pauloapanucci/tcc/README.md

# tcc
Repositório de códigos, imagens e fontes de LaTex do TCC desenvolvido por Paulo Alexandre Piornedo Panucci RA 88380 

Departamento de Informática

Universidade Estadual de Maringá
