pauloapanucci/tcc/imgs/screen2.gif

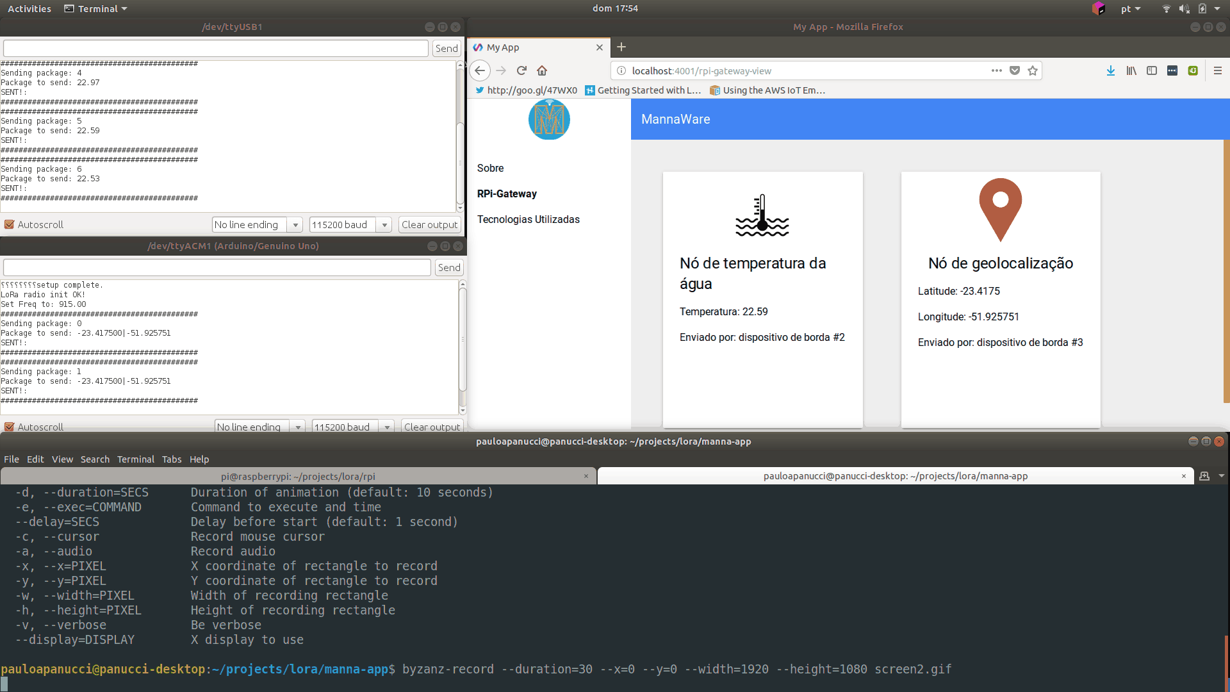
imgs/screen2.gif
