pauloapanucci/tcc/latex-repo/bigpicprototipo.png

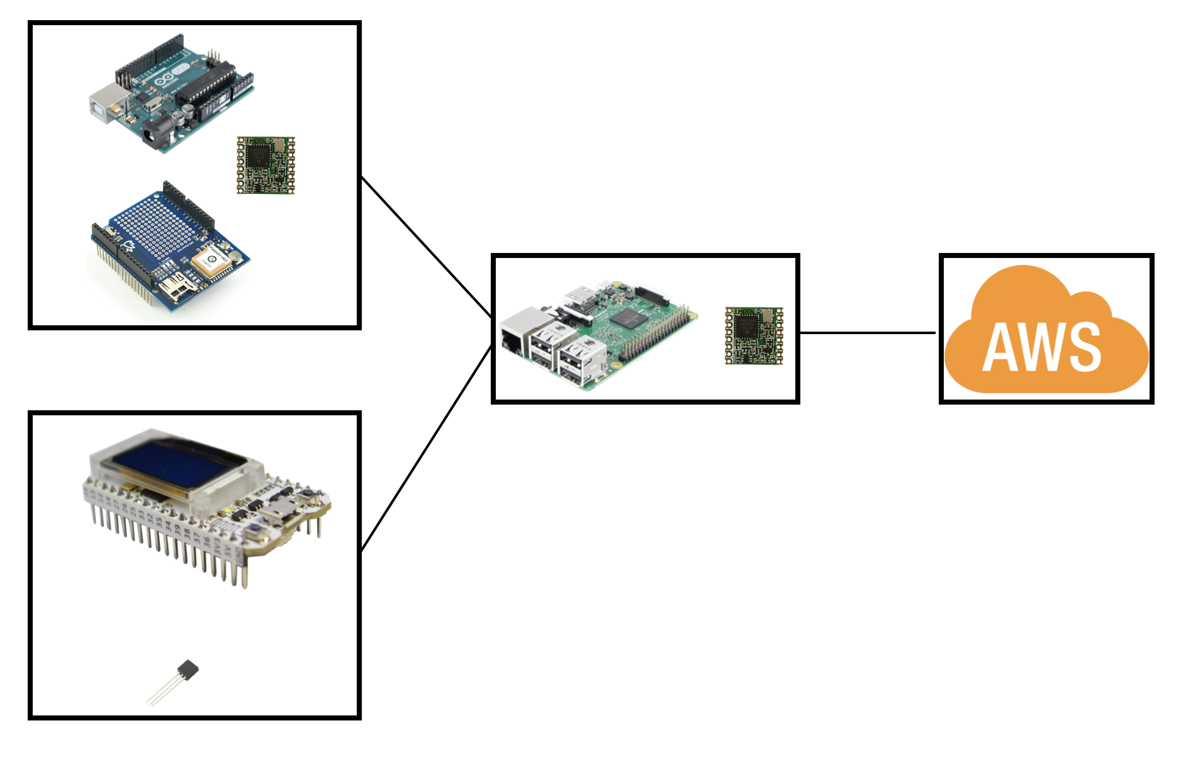
latex-repo/bigpicprototipo.png
