pauloapanucci/tcc/src/mannaware/images/manna.png

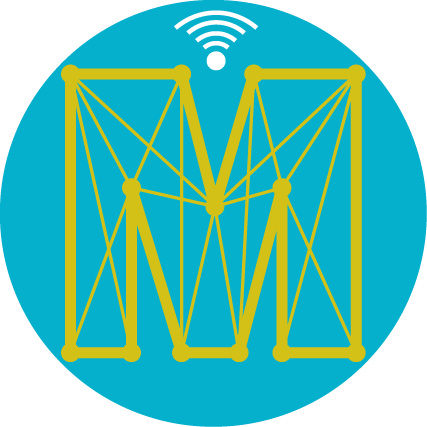
src/mannaware/images/manna.png
