pauloapanucci/tcc/src/mannaware/images/watertemp.png

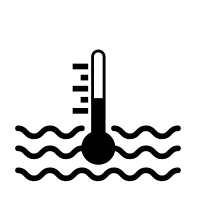
src/mannaware/images/watertemp.png
