pauloapanucci/tcc/src/mannaware/scripts/desktop2.gif

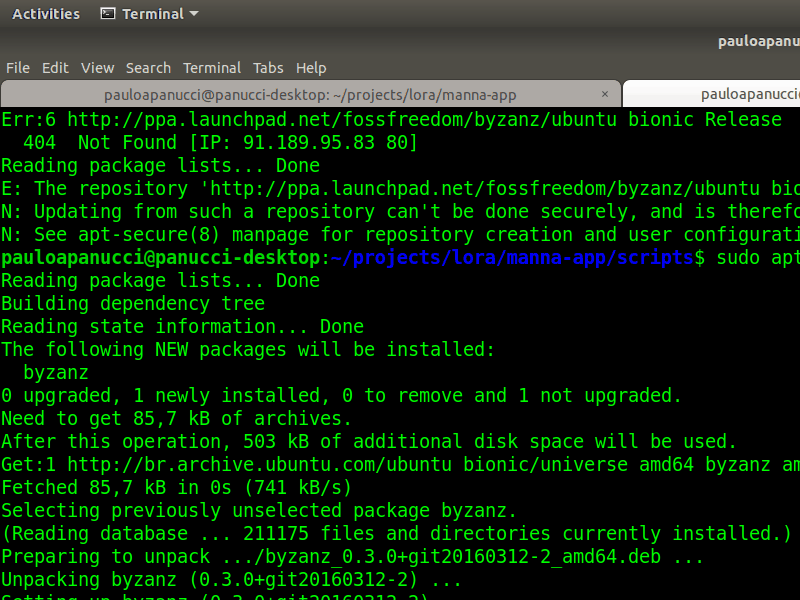
src/mannaware/scripts/desktop2.gif
