pauloapanucci/tcc/src/mannaware/scripts/desktop.gif

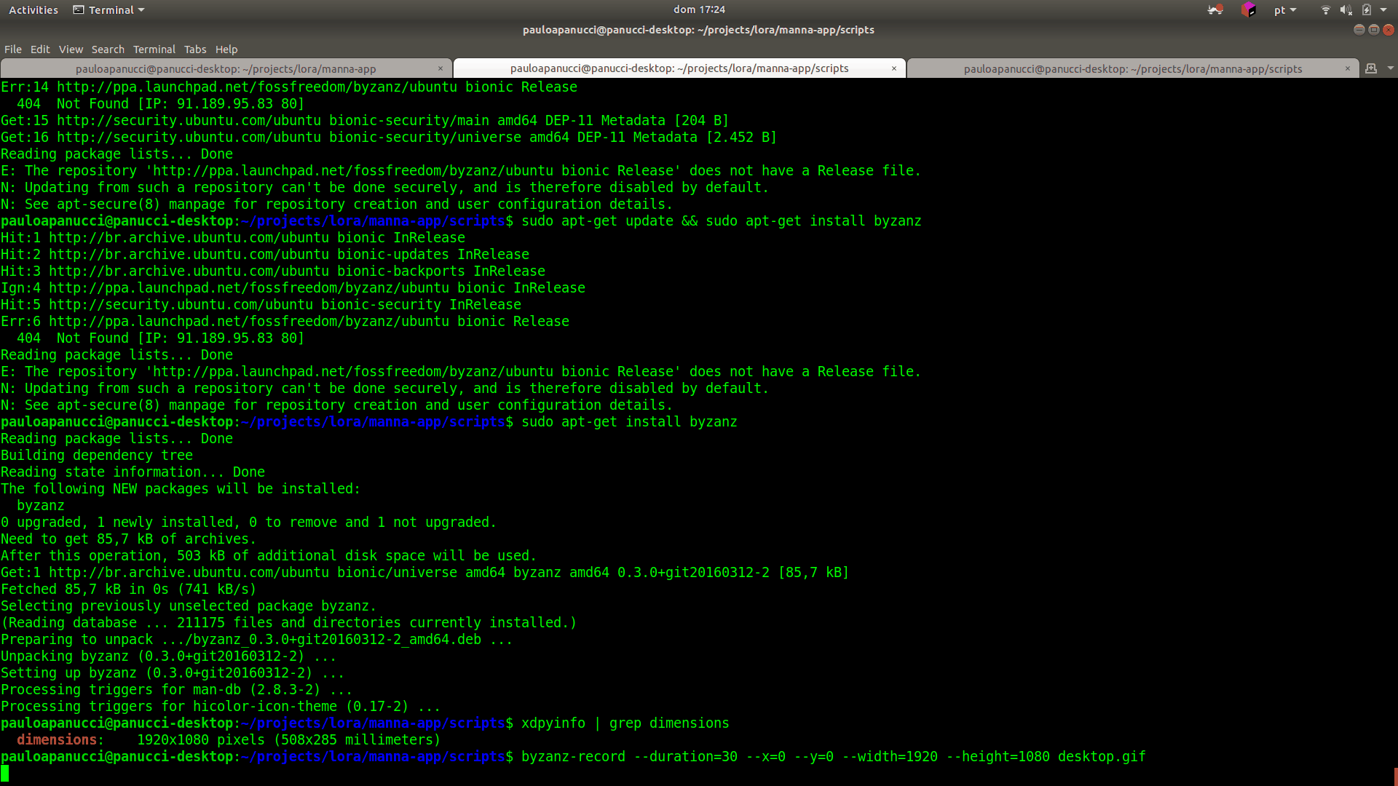
src/mannaware/scripts/desktop.gif
