pauloapanucci/tcc/src/setup/Heltec_WIFI-LoRa-32_DiagramPinout.jpg

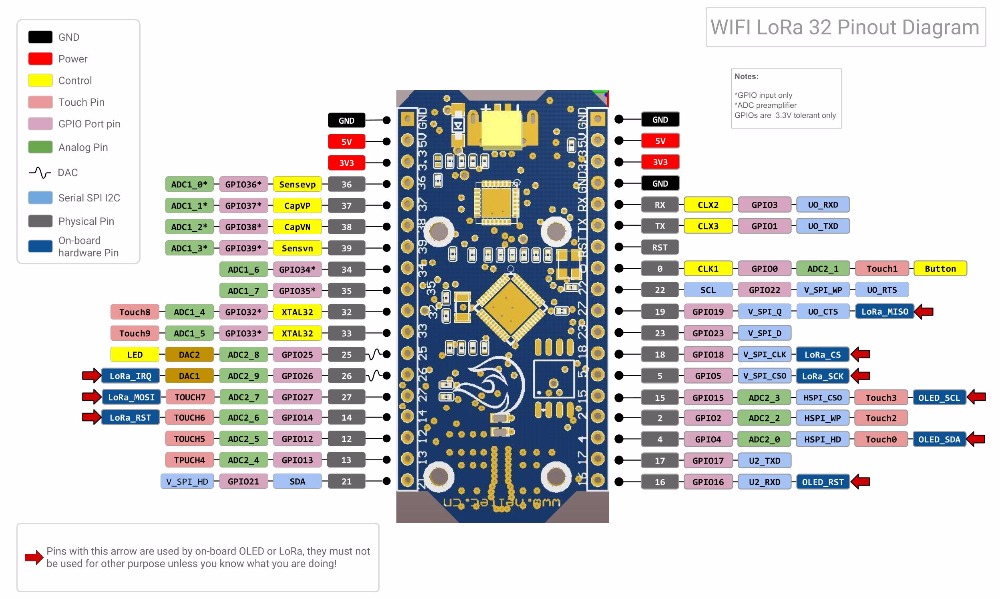
src/setup/Heltec_WIFI-LoRa-32_DiagramPinout.jpg
