pauloapanucci/tcc/src/setup/arduinomicro-rfm95pw.jpeg

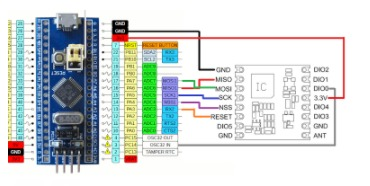
src/setup/arduinomicro-rfm95pw.jpeg
