pauloapanucci/tcc/src/setup/arduinouno-rfm95w.jpeg

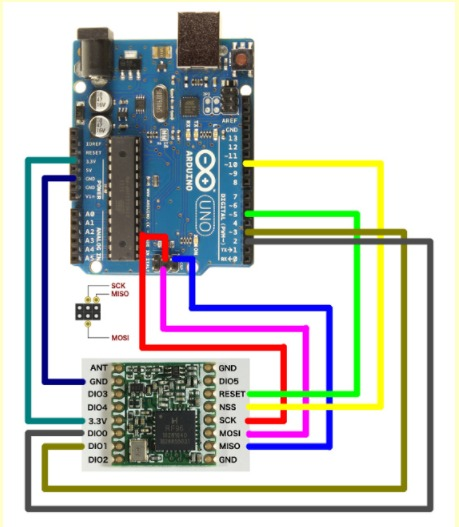
src/setup/arduinouno-rfm95w.jpeg
