pauloapanucci/tcc/src/setup/HopeRF_RFM95PW-schema.png

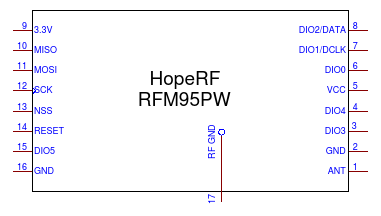
src/setup/HopeRF_RFM95PW-schema.png
