pauloapanucci/tcc/src/setup/RFM95W- Layout.jpg

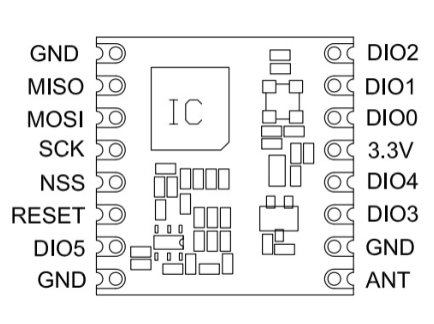
src/setup/RFM95W- Layout.jpg
