pauloapanucci/tcc/(list of files, drawings)

Other design files:
imgs/rpi-rf.fzz
imgs/uno-rf.fzz
