pauloapanucci/tcc/src/gateway/gateway.cpp

#include <bcm2835.h>
#include <stdio.h>
#include <signal.h>
#include <unistd.h>
#include <stdlib.h>
#include <ctype.h>
#include <string.h>
#include <limits.h>

#include "aws_iot_config.h"
#include "aws_iot_log.h"
#include "aws_iot_version.h"
#include "aws_iot_mqtt_client_interface.h"
#include "aws_iot_shadow_interface.h"

#include <RH_RF69.h>
#include <RH_RF95.h>

// define hardware used change to fit your need
// Uncomment the board you have, if not listed 
// uncommment custom board and set wiring tin custom section

// LoRasPi board 
// see https://github.com/hallard/LoRasPI
#define BOARD_LORASPI

// iC880A and LinkLab Lora Gateway Shield (if RF module plugged into)
// see https://github.com/ch2i/iC880A-Raspberry-PI
//#define BOARD_IC880A_PLATE

// Raspberri PI Lora Gateway for multiple modules 
// see https://github.com/hallard/RPI-Lora-Gateway
//#define BOARD_PI_LORA_GATEWAY

// Dragino Raspberry PI hat
// see https://github.com/dragino/Lora
//#define BOARD_DRAGINO_PIHAT

// Now we include RasPi_Boards.h so this will expose defined 
// constants with CS/IRQ/RESET/on board LED pins definition
#include "./RadioHead/examples/raspi/RasPiBoards.h"

// Our RFM95 Configuration 
#define RF_FREQUENCY  915.00
#define RF_NODE_ID    1

// Create an instance of a driver
RH_RF95 rf95(RF_CS_PIN, RF_IRQ_PIN);
//RH_RF95 rf95(RF_CS_PIN);

//Flag for Ctrl-C
volatile sig_atomic_t force_exit = false;

//AWS EXAMPLE
#define ROOMTEMPERATURE_UPPERLIMIT 32.0f
#define ROOMTEMPERATURE_LOWERLIMIT 25.0f
#define STARTING_ROOMTEMPERATURE ROOMTEMPERATURE_LOWERLIMIT

#define MAX_LENGTH_OF_UPDATE_JSON_BUFFER 200

static char certDirectory[PATH_MAX + 1] = "../../../certs";
#define HOST_ADDRESS_SIZE 255
static char HostAddress[HOST_ADDRESS_SIZE] = AWS_IOT_MQTT_HOST;
static uint32_t port = AWS_IOT_MQTT_PORT;
static uint8_t numPubs = 5;

static void simulateRoomTemperature(float *pRoomTemperature) {
	static float deltaChange;

	if(*pRoomTemperature >= ROOMTEMPERATURE_UPPERLIMIT) {
		deltaChange = -0.5f;
	} else if(*pRoomTemperature <= ROOMTEMPERATURE_LOWERLIMIT) {
		deltaChange = 0.5f;
	}

	*pRoomTemperature += deltaChange;
}

void ShadowUpdateStatusCallback(const char *pThingName, ShadowActions_t action, Shadow_Ack_Status_t status,
								const char *pReceivedJsonDocument, void *pContextData) {
	IOT_UNUSED(pThingName);
	IOT_UNUSED(action);
	IOT_UNUSED(pReceivedJsonDocument);
	IOT_UNUSED(pContextData);

	if(SHADOW_ACK_TIMEOUT == status) {
		IOT_INFO("Update Timeout--");
	} else if(SHADOW_ACK_REJECTED == status) {
		IOT_INFO("Update RejectedXX");
	} else if(SHADOW_ACK_ACCEPTED == status) {
		IOT_INFO("Update Accepted !!");
	}
}

void windowActuate_Callback(const char *pJsonString, uint32_t JsonStringDataLen, jsonStruct_t *pContext) {
	IOT_UNUSED(pJsonString);
	IOT_UNUSED(JsonStringDataLen);

	if(pContext != NULL) {
		IOT_INFO("Delta - Window state changed to %d", *(bool *) (pContext->pData));
	}
}

void parseInputArgsForConnectParams(int argc, char **argv) {
	int opt;

	while(-1 != (opt = getopt(argc, argv, "h:p:c:n:"))) {
		switch(opt) {
			case 'h':
				strncpy(HostAddress, optarg, HOST_ADDRESS_SIZE);
				IOT_DEBUG("Host %s", optarg);
				break;
			case 'p':
				port = atoi(optarg);
				IOT_DEBUG("arg %s", optarg);
				break;
			case 'c':
				strncpy(certDirectory, optarg, PATH_MAX + 1);
				IOT_DEBUG("cert root directory %s", optarg);
				break;
			case 'n':
				numPubs = atoi(optarg);
				IOT_DEBUG("num pubs %s", optarg);
				break;
			case '?':
				if(optopt == 'c') {
					IOT_ERROR("Option -%c requires an argument.", optopt);
				} else if(isprint(optopt)) {
					IOT_WARN("Unknown option `-%c'.", optopt);
				} else {
					IOT_WARN("Unknown option character `\\x%x'.", optopt);
				}
				break;
			default:
				IOT_ERROR("ERROR in command line argument parsing");
				break;
		}
	}

}

//END AWS EXAMPLE

// int main(int argc, char **argv) {
	// IoT_Error_t rc = FAILURE;
	// int32_t i = 0;

	// char JsonDocumentBuffer[MAX_LENGTH_OF_UPDATE_JSON_BUFFER];
	// size_t sizeOfJsonDocumentBuffer = sizeof(JsonDocumentBuffer) / sizeof(JsonDocumentBuffer[0]);
	// char *pJsonStringToUpdate;
	// float temperature = 0.0;

	// bool windowOpen = false;
	// jsonStruct_t windowActuator;
	// windowActuator.cb = windowActuate_Callback;
	// windowActuator.pData = &windowOpen;
	// windowActuator.dataLength = sizeof(bool);
	// windowActuator.pKey = "windowOpen";
	// windowActuator.type = SHADOW_JSON_BOOL;

	// jsonStruct_t temperatureHandler;
	// temperatureHandler.cb = NULL;
	// temperatureHandler.pKey = "temperature";
	// temperatureHandler.pData = &temperature;
	// temperatureHandler.dataLength = sizeof(float);
	// temperatureHandler.type = SHADOW_JSON_FLOAT;

	// char rootCA[PATH_MAX + 1];
	// char clientCRT[PATH_MAX + 1];
	// char clientKey[PATH_MAX + 1];
	// char CurrentWD[PATH_MAX + 1];

	// IOT_INFO("\nAWS IoT SDK Version %d.%d.%d-%s\n", VERSION_MAJOR, VERSION_MINOR, VERSION_PATCH, VERSION_TAG);

	// getcwd(CurrentWD, sizeof(CurrentWD));
	// snprintf(rootCA, PATH_MAX + 1, "%s/%s/%s", CurrentWD, certDirectory, AWS_IOT_ROOT_CA_FILENAME);
	// snprintf(clientCRT, PATH_MAX + 1, "%s/%s/%s", CurrentWD, certDirectory, AWS_IOT_CERTIFICATE_FILENAME);
	// snprintf(clientKey, PATH_MAX + 1, "%s/%s/%s", CurrentWD, certDirectory, AWS_IOT_PRIVATE_KEY_FILENAME);

	// IOT_DEBUG("rootCA %s", rootCA);
	// IOT_DEBUG("clientCRT %s", clientCRT);
	// IOT_DEBUG("clientKey %s", clientKey);

	// parseInputArgsForConnectParams(argc, argv);

	// // initialize the mqtt client
	// AWS_IoT_Client mqttClient;

	// ShadowInitParameters_t sp = ShadowInitParametersDefault;
	// sp.pHost = AWS_IOT_MQTT_HOST;
	// sp.port = AWS_IOT_MQTT_PORT;
	// sp.pClientCRT = clientCRT;
	// sp.pClientKey = clientKey;
	// sp.pRootCA = rootCA;
	// sp.enableAutoReconnect = false;
	// sp.disconnectHandler = NULL;

	// IOT_INFO("Shadow Init");
	// rc = aws_iot_shadow_init(&mqttClient, &sp);
	// if(SUCCESS != rc) {
	// 	IOT_ERROR("Shadow Connection Error");
	// 	return rc;
	// }

	// ShadowConnectParameters_t scp = ShadowConnectParametersDefault;
	// scp.pMyThingName = AWS_IOT_MY_THING_NAME;
	// scp.pMqttClientId = AWS_IOT_MQTT_CLIENT_ID;
	// scp.mqttClientIdLen = (uint16_t) strlen(AWS_IOT_MQTT_CLIENT_ID);

	// IOT_INFO("Shadow Connect");
	// rc = aws_iot_shadow_connect(&mqttClient, &scp);
	// if(SUCCESS != rc) {
	// 	IOT_ERROR("Shadow Connection Error");
	// 	return rc;
	// }

	// /*
	//  * Enable Auto Reconnect functionality. Minimum and Maximum time of Exponential backoff are set in aws_iot_config.h
	//  *  #AWS_IOT_MQTT_MIN_RECONNECT_WAIT_INTERVAL
	//  *  #AWS_IOT_MQTT_MAX_RECONNECT_WAIT_INTERVAL
	//  */
	// rc = aws_iot_shadow_set_autoreconnect_status(&mqttClient, true);
	// if(SUCCESS != rc) {
	// 	IOT_ERROR("Unable to set Auto Reconnect to true - %d", rc);
	// 	return rc;
	// }

	// rc = aws_iot_shadow_register_delta(&mqttClient, &windowActuator);

	// if(SUCCESS != rc) {
	// 	IOT_ERROR("Shadow Register Delta Error");
	// }
	// temperature = STARTING_ROOMTEMPERATURE;

	// // loop and publish a change in temperature
	// while(NETWORK_ATTEMPTING_RECONNECT == rc || NETWORK_RECONNECTED == rc || SUCCESS == rc) {
	// 	rc = aws_iot_shadow_yield(&mqttClient, 200);
	// 	if(NETWORK_ATTEMPTING_RECONNECT == rc) {
	// 		sleep(1);
	// 		// If the client is attempting to reconnect we will skip the rest of the loop.
	// 		continue;
	// 	}
	// 	IOT_INFO("\n=======================================================================================\n");
	// 	IOT_INFO("On Device: window state %s", windowOpen ? "true" : "false");
	// 	simulateRoomTemperature(&temperature);

	// 	rc = aws_iot_shadow_init_json_document(JsonDocumentBuffer, sizeOfJsonDocumentBuffer);
	// 	if(SUCCESS == rc) {
	// 		rc = aws_iot_shadow_add_reported(JsonDocumentBuffer, sizeOfJsonDocumentBuffer, 2, &temperatureHandler,
	// 										 &windowActuator);
	// 		if(SUCCESS == rc) {
	// 			rc = aws_iot_finalize_json_document(JsonDocumentBuffer, sizeOfJsonDocumentBuffer);
	// 			if(SUCCESS == rc) {
	// 				IOT_INFO("Update Shadow: %s", JsonDocumentBuffer);
	// 				rc = aws_iot_shadow_update(&mqttClient, AWS_IOT_MY_THING_NAME, JsonDocumentBuffer,
	// 										   ShadowUpdateStatusCallback, NULL, 4, true);
	// 			}
	// 		}
	// 	}
	// 	IOT_INFO("*****************************************************************************************\n");
	// 	sleep(1);
	// }

	// if(SUCCESS != rc) {
	// 	IOT_ERROR("An error occurred in the loop %d", rc);
	// }

	// IOT_INFO("Disconnecting");
	// rc = aws_iot_shadow_disconnect(&mqttClient);

	// if(SUCCESS != rc) {
	// 	IOT_ERROR("Disconnect error %d", rc);
	// }

	// return rc;
// }

void sig_handler(int sig)
{
  printf("\n%s Break received, exiting!\n", __BASEFILE__);
  force_exit=true;
}

//Main Function
int main (int argc, const char* argv[] )
{
  unsigned long led_blink = 0;
  
  signal(SIGINT, sig_handler);
  printf( "%s\n", __BASEFILE__);

  if (!bcm2835_init()) {
    fprintf( stderr, "%s bcm2835_init() Failed\n\n", __BASEFILE__ );
    return 1;
  }
  
  printf( "RF95 CS=GPIO%d", RF_CS_PIN);

#ifdef RF_LED_PIN
  pinMode(RF_LED_PIN, OUTPUT);
  digitalWrite(RF_LED_PIN, HIGH );
#endif

#ifdef RF_IRQ_PIN
  printf( ", IRQ=GPIO%d", RF_IRQ_PIN );
  // IRQ Pin input/pull down
  pinMode(RF_IRQ_PIN, INPUT);
  bcm2835_gpio_set_pud(RF_IRQ_PIN, BCM2835_GPIO_PUD_DOWN);
  // Now we can enable Rising edge detection
  bcm2835_gpio_ren(RF_IRQ_PIN);
#endif
  
#ifdef RF_RST_PIN
  printf( ", RST=GPIO%d", RF_RST_PIN );
  // Pulse a reset on module
  pinMode(RF_RST_PIN, OUTPUT);
  digitalWrite(RF_RST_PIN, LOW );
  bcm2835_delay(150);
  digitalWrite(RF_RST_PIN, HIGH );
  bcm2835_delay(100);
#endif

#ifdef RF_LED_PIN
  printf( ", LED=GPIO%d", RF_LED_PIN );
  digitalWrite(RF_LED_PIN, LOW );
#endif

  if (!rf95.init()) {
    fprintf( stderr, "\nRF95 module init failed, Please verify wiring/module\n" );
  } else {
    // Defaults after init are 434.0MHz, 13dBm, Bw = 125 kHz, Cr = 4/5, Sf = 128chips/symbol, CRC on

    // The default transmitter power is 13dBm, using PA_BOOST.
    // If you are using RFM95/96/97/98 modules which uses the PA_BOOST transmitter pin, then 
    // you can set transmitter powers from 5 to 23 dBm:
    //  driver.setTxPower(23, false);
    // If you are using Modtronix inAir4 or inAir9,or any other module which uses the
    // transmitter RFO pins and not the PA_BOOST pins
    // then you can configure the power transmitter power for -1 to 14 dBm and with useRFO true. 
    // Failure to do that will result in extremely low transmit powers.
    // rf95.setTxPower(14, true);


    // RF95 Modules don't have RFO pin connected, so just use PA_BOOST
    // check your country max power useable, in EU it's +14dB
    rf95.setTxPower(14, false);

    // You can optionally require this module to wait until Channel Activity
    // Detection shows no activity on the channel before transmitting by setting
    // the CAD timeout to non-zero:
    //rf95.setCADTimeout(10000);

    // Adjust Frequency
    rf95.setFrequency(RF_FREQUENCY);
    
    // If we need to send something
    rf95.setThisAddress(RF_NODE_ID);
    rf95.setHeaderFrom(RF_NODE_ID);
    
    // Be sure to grab all node packet 
    // we're sniffing to display, it's a demo
    rf95.setPromiscuous(true);

    // We're ready to listen for incoming message
    rf95.setModeRx();

    printf( " OK NodeID=%d @ %3.2fMHz\n", RF_NODE_ID, RF_FREQUENCY );
    printf( "Listening packet...\n" );

    //Begin the main body of code
    while (!force_exit) {
      
#ifdef RF_IRQ_PIN
      // We have a IRQ pin ,pool it instead reading
      // Modules IRQ registers from SPI in each loop
      
      // Rising edge fired ?
      if (bcm2835_gpio_eds(RF_IRQ_PIN)) {
        // Now clear the eds flag by setting it to 1
        bcm2835_gpio_set_eds(RF_IRQ_PIN);
        //printf("Packet Received, Rising event detect for pin GPIO%d\n", RF_IRQ_PIN);
#endif

        if (rf95.available()) { 
#ifdef RF_LED_PIN
          led_blink = millis();
          digitalWrite(RF_LED_PIN, HIGH);
#endif
          // Should be a message for us now
          uint8_t buf[RH_RF95_MAX_MESSAGE_LEN];
          uint8_t len  = sizeof(buf);
          uint8_t from = rf95.headerFrom();
          uint8_t to   = rf95.headerTo();
          uint8_t id   = rf95.headerId();
          uint8_t flags= rf95.headerFlags();;
          int8_t rssi  = rf95.lastRssi();
          
          if (rf95.recv(buf, &len)) {
            printf("Packet[%02d] #%d => #%d %ddB: ", len, from, to, rssi);
            printbuffer(buf, len);
          } else {
            Serial.print("receive failed");
          }
          printf("\n");
        }
        
#ifdef RF_IRQ_PIN
      }
#endif
      
#ifdef RF_LED_PIN
      // Led blink timer expiration ?
      if (led_blink && millis()-led_blink>200) {
        led_blink = 0;
        digitalWrite(RF_LED_PIN, LOW);
      }
#endif
      // Let OS doing other tasks
      // For timed critical appliation you can reduce or delete
      // this delay, but this will charge CPU usage, take care and monitor
      bcm2835_delay(5);
    }
  }

#ifdef RF_LED_PIN
  digitalWrite(RF_LED_PIN, LOW );
#endif
  printf( "\n%s Ending\n", __BASEFILE__ );
  bcm2835_close();
  return 0;
}
